CU-Rocketry/kicad-library/3d_models/RF_Antenna_Johanson_2450AT42E010BE.STEP

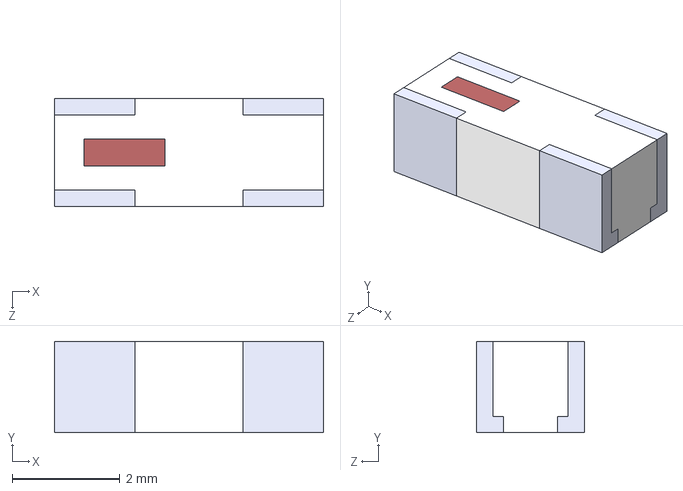
[picture p1: CAD file, 2026-07-11]
3d_models/RF_Antenna_Johanson_2450AT42E010BE.STEP
5.00 x 1.70 x 2.00 mm
