CU-Rocketry/kicad-library/3d_models/Wio-S3 Wireless Module_3D.step

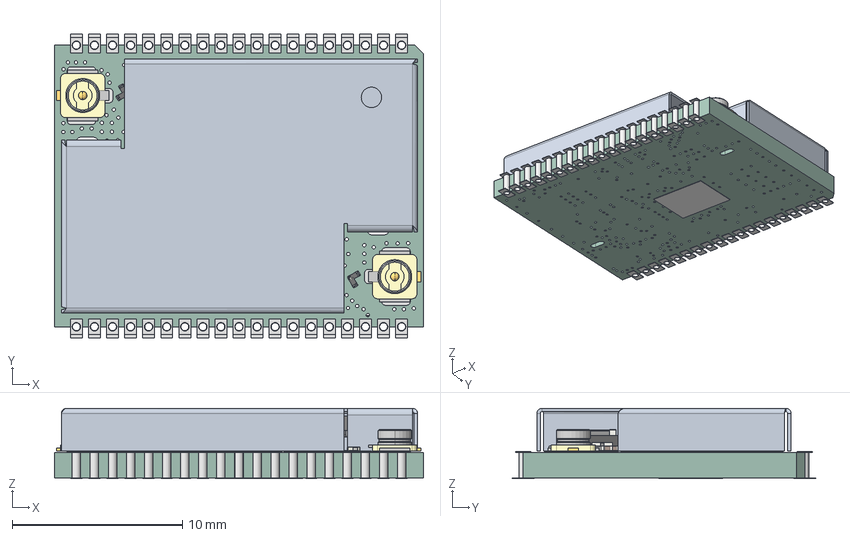
[picture p2: CAD file, 2026-07-07]
3d_models/Wio-S3 Wireless Module_3D.step
21.6 x 17.8 x 4.13 mm
C_0201_0603Metric x 35
L_0201_0603Metric x 7
R_0201_0603Metric x 10
C_0402_1005Metric x 7
Wio-S3 Wireless Module_3D 1.18.1
L_0402_1005Metric x 6
U.FL-R-SMT-1 x 2
Wio-S3 Wireless Module_3D 1.42.1
Wio-S3 Wireless Module å±è½ç½©
L_0805_2012Metric
Crystal_SMD_SeikoEpson_FA238-4Pin_2.5x2.0mm
QFN56-7x7
SOIC-8_5.275x5.275mm_P1.27mm
QFN24 4x4
SOD-523
Wio-S3 Wireless Module_pad
Wio-S3 Wireless Module_PCB
