CU-Rocketry/kicad-library/3d_models/CP_Radial_D13.5mm_P5.00mm_H8.00mm.step

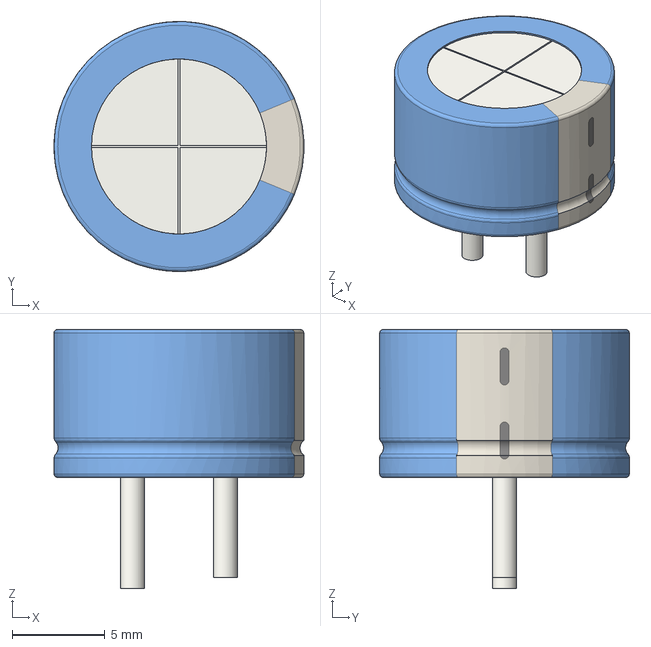
[picture p3: CAD file, 2026-07-04]
3d_models/CP_Radial_D13.5mm_P5.00mm_H8.00mm.step
13.5 x 13.5 x 14.0 mm
