CU-Rocketry/kicad-library/3d_models/GCT_USB4940-00-A.step

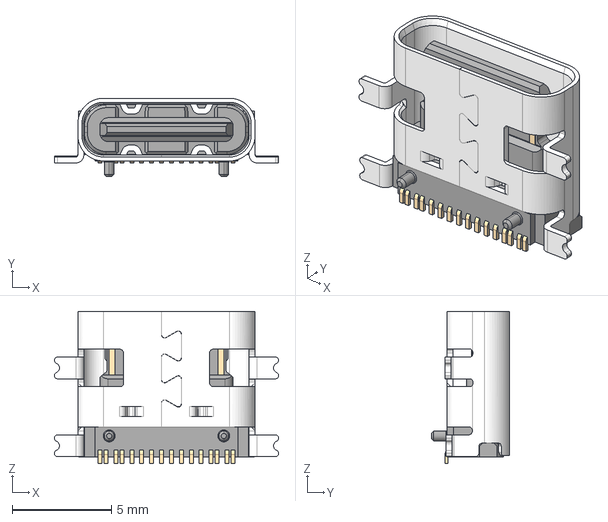
[picture p4: CAD file, 2026-07-04]
3d_models/GCT_USB4940-00-A.step
11.3 x 3.96 x 7.68 mm
