CU-Rocketry/kicad-library/3d_models/BA1AAPC.step

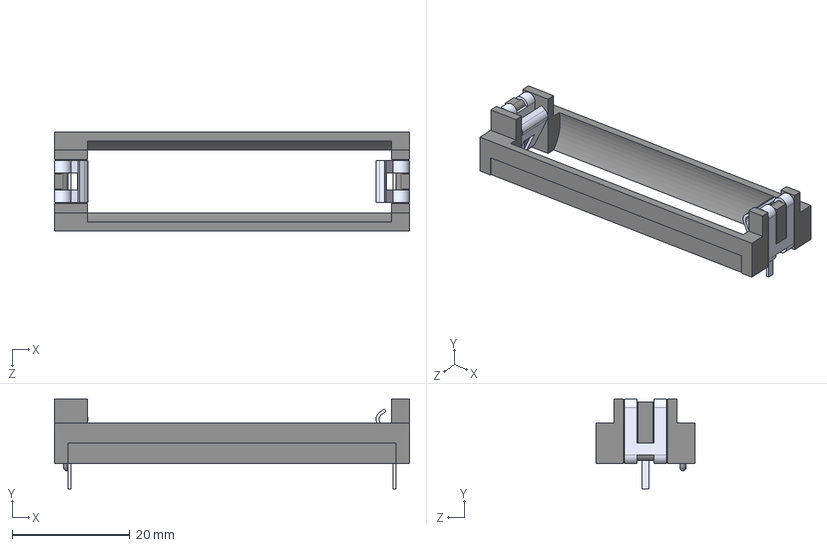
[picture p5: CAD file, 2026-06-29]
3d_models/BA1AAPC.step
60.2 x 15.2 x 16.8 mm
