CU-Rocketry/kicad-library/3d_models/FTSH-107-01-L-DV-K.step

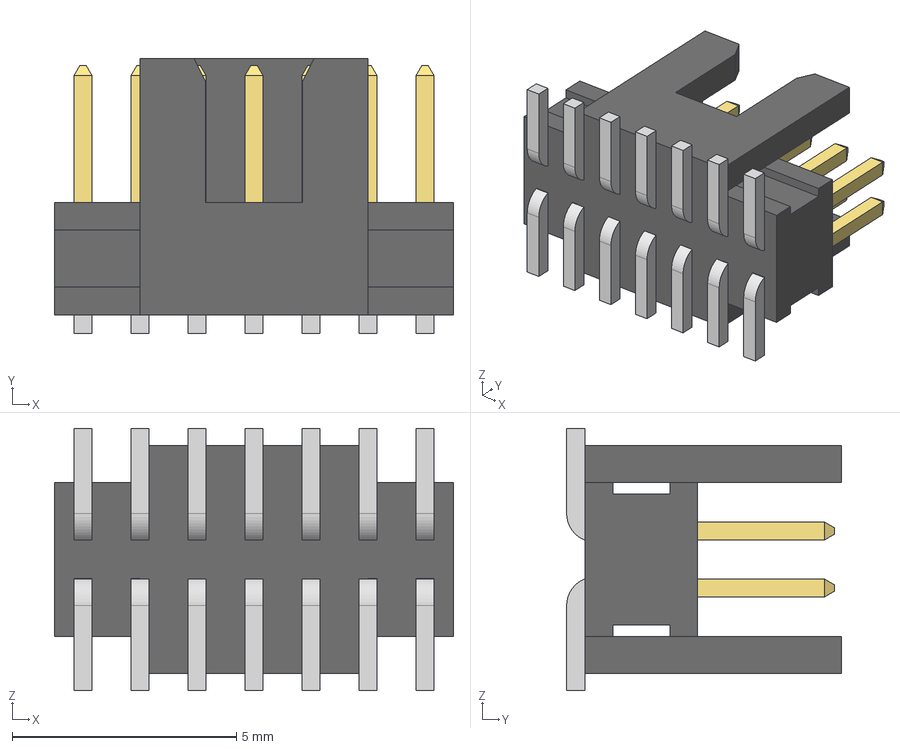
[picture p6: CAD file, 2026-06-27]
3d_models/FTSH-107-01-L-DV-K.step
8.89 x 6.12 x 5.84 mm
FTSH-107-01-L-DV-K_body
FTSH-107-01-L-DV-K_pins1
FTSH-107-01-L-DV-K_pins2
