CU-Rocketry/kicad-library/3d_models/UJ20-C-H-G-SMT-2A-P16-TR.step

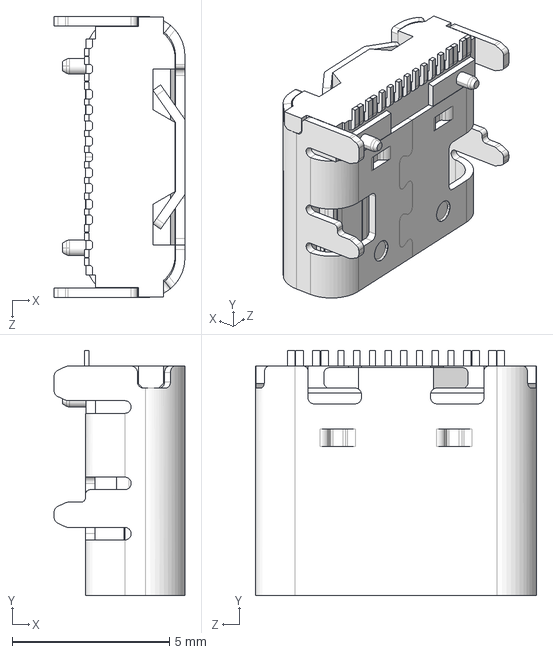
[picture p7: CAD file, 2026-06-27]
3d_models/UJ20-C-H-G-SMT-2A-P16-TR.step
4.16 x 7.80 x 8.94 mm
