CU-Rocketry/kicad-library/3d_models/ublox-SAM-M10Q-00B.step

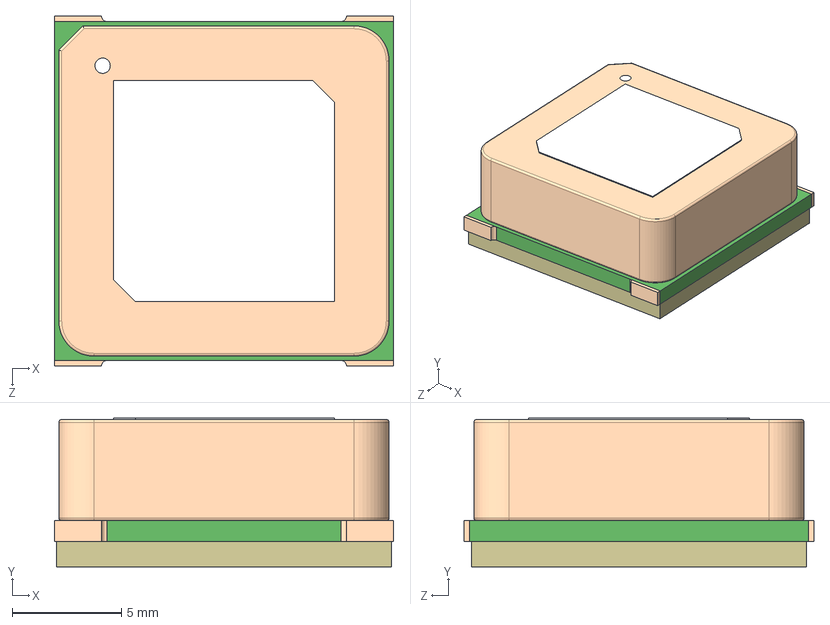
[picture p8: CAD file, 2026-06-19]
3d_models/ublox-SAM-M10Q-00B.step
15.5 x 6.80 x 16.0 mm
