CU-Rocketry/kicad-library/3d_models/E22-400MM22S.step

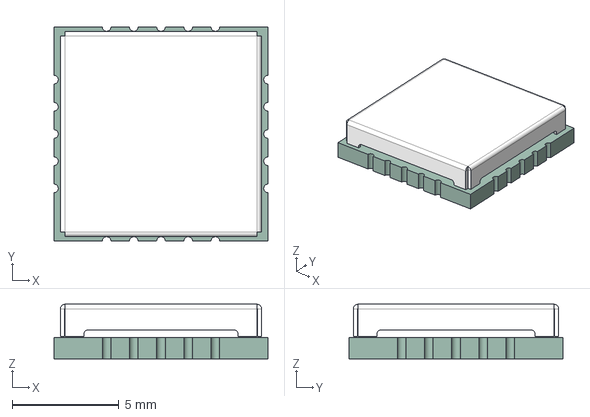
[picture p9: CAD file, 2026-04-06]
3d_models/E22-400MM22S.step
10.0 x 10.0 x 2.55 mm
PBZ-135
10705-V1.1_PCB
