CU-Rocketry/kicad-library/3d_models/XT30U-M.step

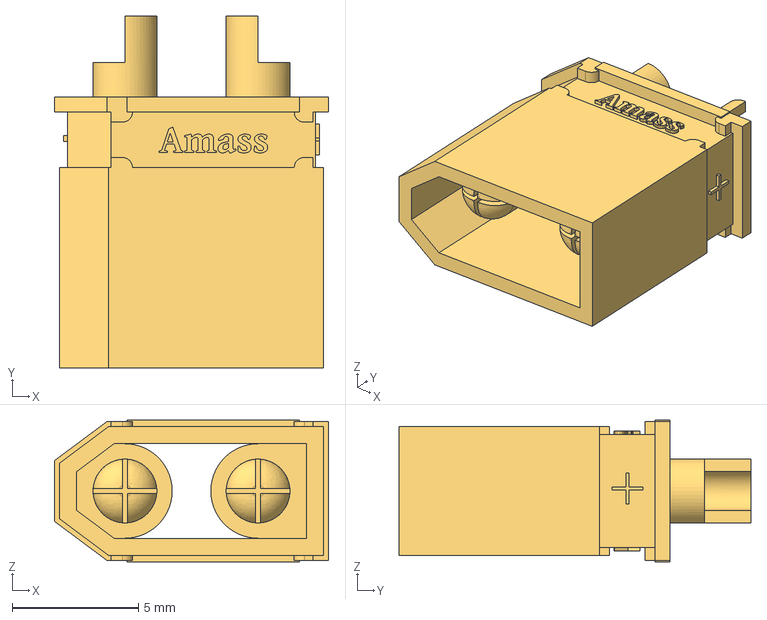
[picture p10: CAD file, 2026-04-06]
3d_models/XT30U-M.step
10.9 x 14.0 x 5.62 mm
