CU-Rocketry/kicad-library/3d_models/Same_Sky_TB0011-350-02GR.step

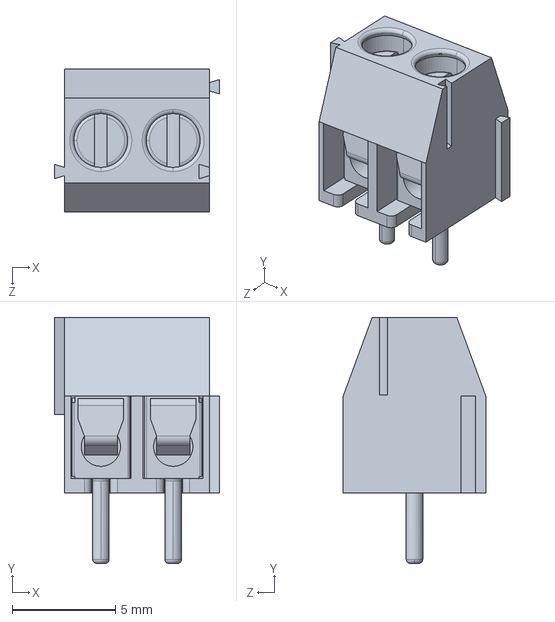
[picture p11: CAD file, 2026-04-06]
3d_models/Same_Sky_TB0011-350-02GR.step
8.00 x 11.9 x 6.90 mm
