CU-Rocketry/kicad-library/3d_models/ublox-SAM-M8Q-0.STEP

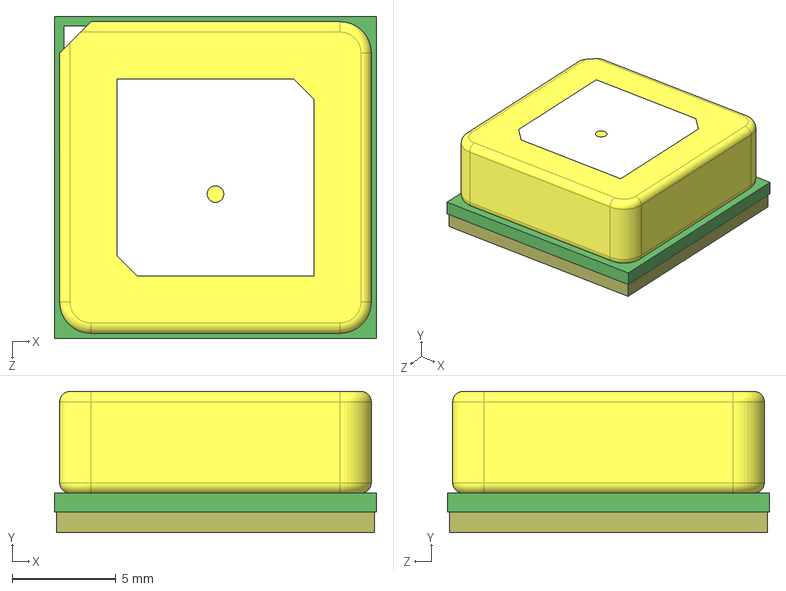
[picture p12: CAD file, 2026-04-06]
3d_models/ublox-SAM-M8Q-0.STEP
15.5 x 6.80 x 15.5 mm
