CU-Rocketry/kicad-library/3d_models/LED_Cree-PLCC4_3.2x2.8mm.step

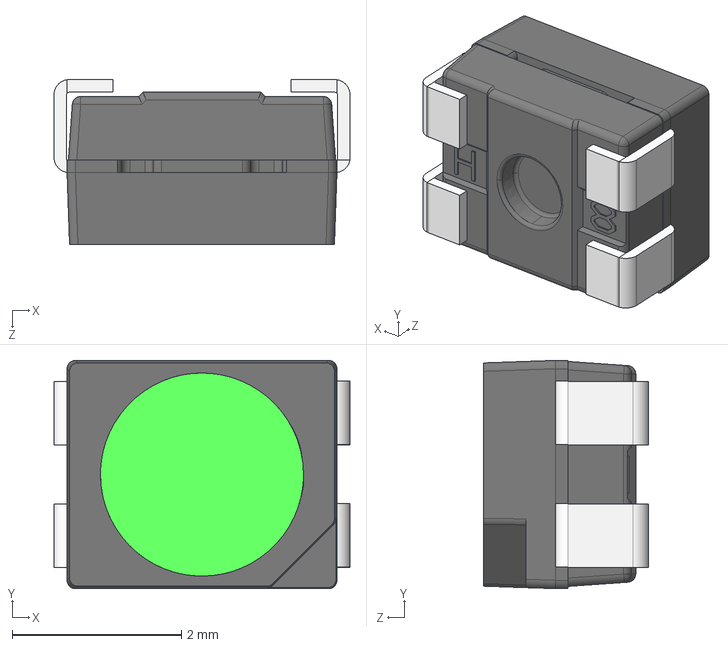
[picture p13: CAD file, 2026-04-06]
3d_models/LED_Cree-PLCC4_3.2x2.8mm.step
3.50 x 2.70 x 1.95 mm
