CU-Rocketry/kicad-library/3d_models/TB0011-350-03GR.step

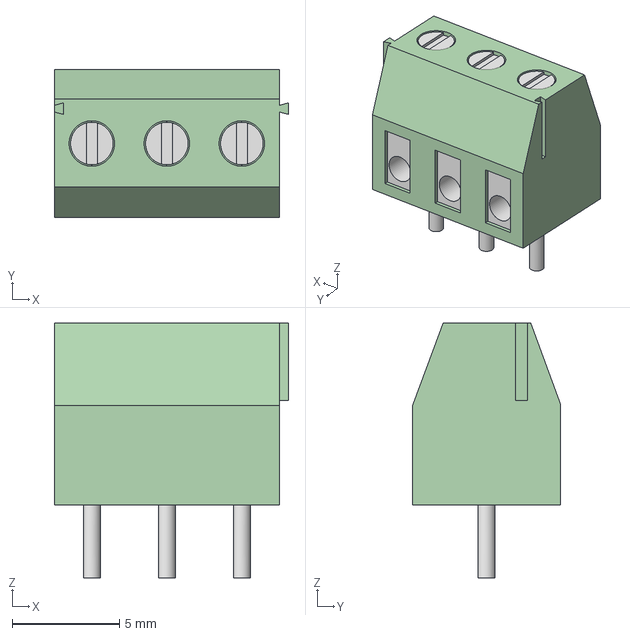
[picture p14: CAD file, 2026-04-06]
3d_models/TB0011-350-03GR.step
10.9 x 6.90 x 11.9 mm
