CU-Rocketry/kicad-library/3d_models/XDFN8_1P6X1P2_onsemi.step

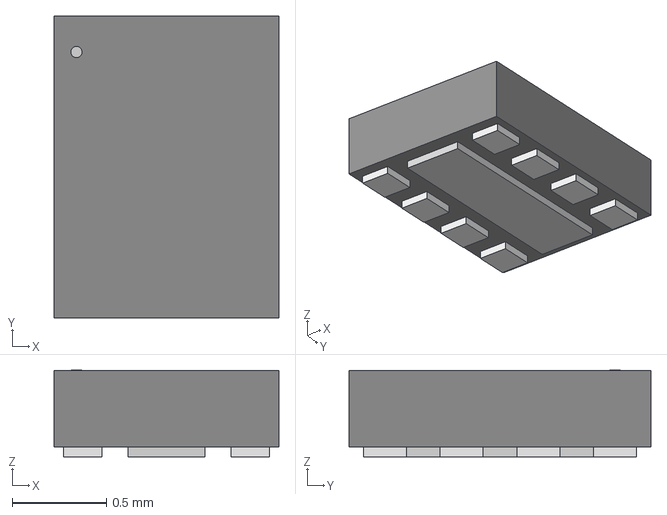
[picture p15: CAD file, 2026-02-26]
3d_models/XDFN8_1P6X1P2_onsemi.step
1.19 x 1.60 x 0.46 mm
