CU-Rocketry/kicad-library/3d_models/TVS_ESDA7P120-1U1M.step

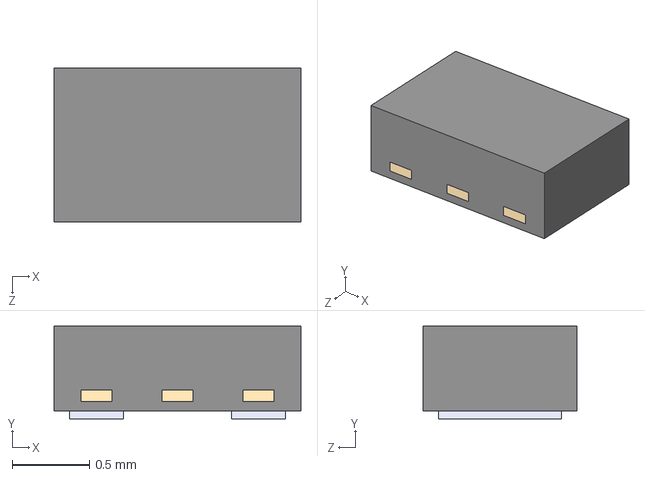
[picture p16: CAD file, 2026-02-18]
3d_models/TVS_ESDA7P120-1U1M.step
1.60 x 0.6 x 1.00 mm
