CU-Rocketry/kicad-library/3d_models/Buzzer_CMT-7525-03-SMT-TR.step

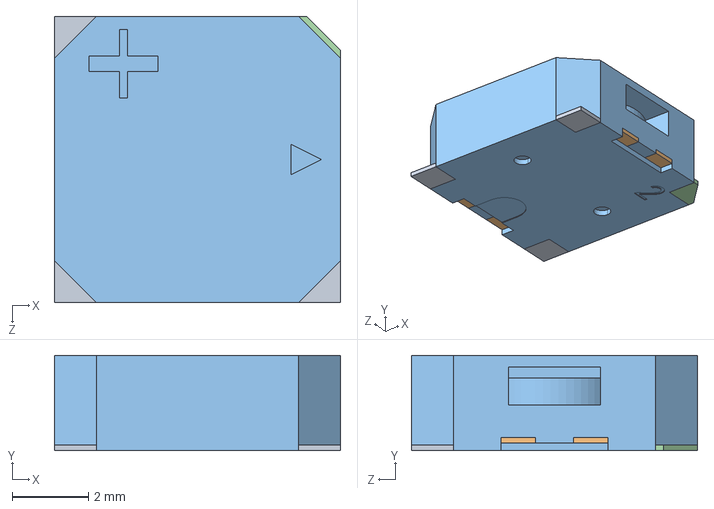
[picture p17: CAD file, 2026-02-12]
3d_models/Buzzer_CMT-7525-03-SMT-TR.step
7.50 x 2.50 x 7.50 mm
