CU-Rocketry/kicad-library/3d_models/NTR4003NT1G.stp

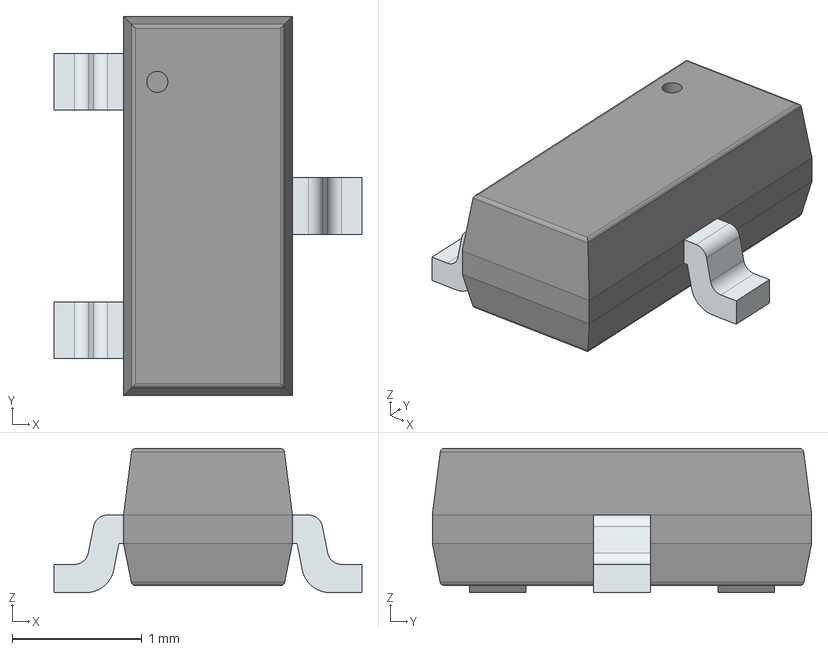
[picture p18: CAD file, 2026-01-28]
3d_models/NTR4003NT1G.stp
2.37 x 2.92 x 1.11 mm
PinsArrayL
FilletPinR
