CU-Rocketry/kicad-library/3d_models/Samtec_FTSH-107-01-X-DV-K-TR.step

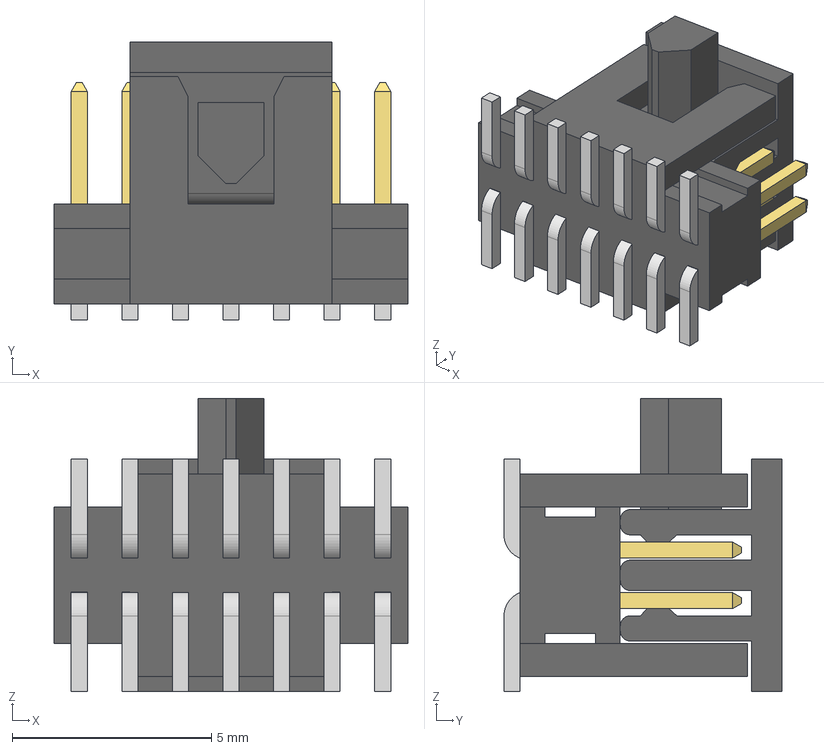
[picture p19: CAD file, 2026-01-27]
3d_models/Samtec_FTSH-107-01-X-DV-K-TR.step
8.89 x 6.98 x 7.37 mm
FTSH-107-01-F-DV-K-P-TR_body
FTSH-107-01-F-DV-K-P-TR_pins1
FTSH-107-01-F-DV-K-P-TR_pins2
FTSH-107-01-F-DV-K-P-TR_pp_pad
