CU-Rocketry/kicad-library/3d_models/UP20-C-F-G-FL-1-P12-TR.step

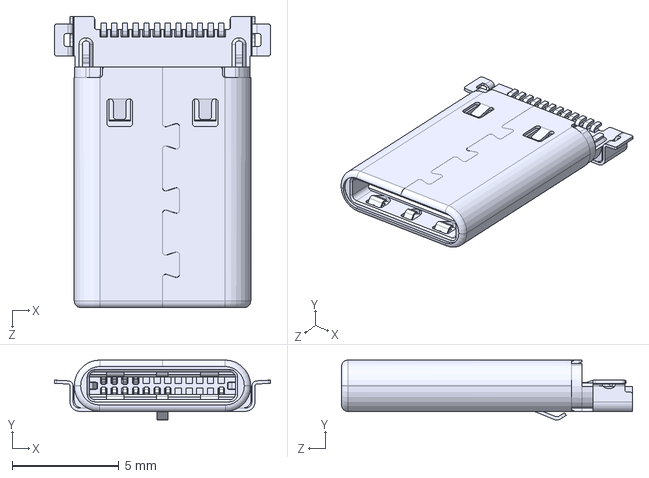
[picture p20: CAD file, 2026-01-27]
3d_models/UP20-C-F-G-FL-1-P12-TR.step
10.1 x 2.80 x 13.6 mm
