CU-Rocketry/kicad-library/3d_models/UJ20-C-H-G-SMT-5-P16-TR.step

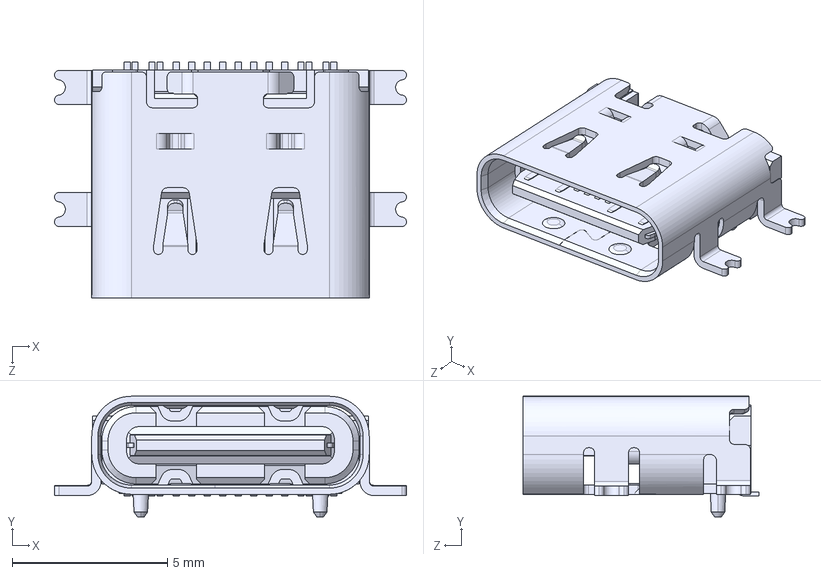
[picture p21: CAD file, 2026-01-27]
3d_models/UJ20-C-H-G-SMT-5-P16-TR.step
11.3 x 3.89 x 7.60 mm
