CU-Rocketry/kicad-library/3d_models/Con_Coaxial_RFSOLUTIONS_CON-SMA-EDGE-S.step

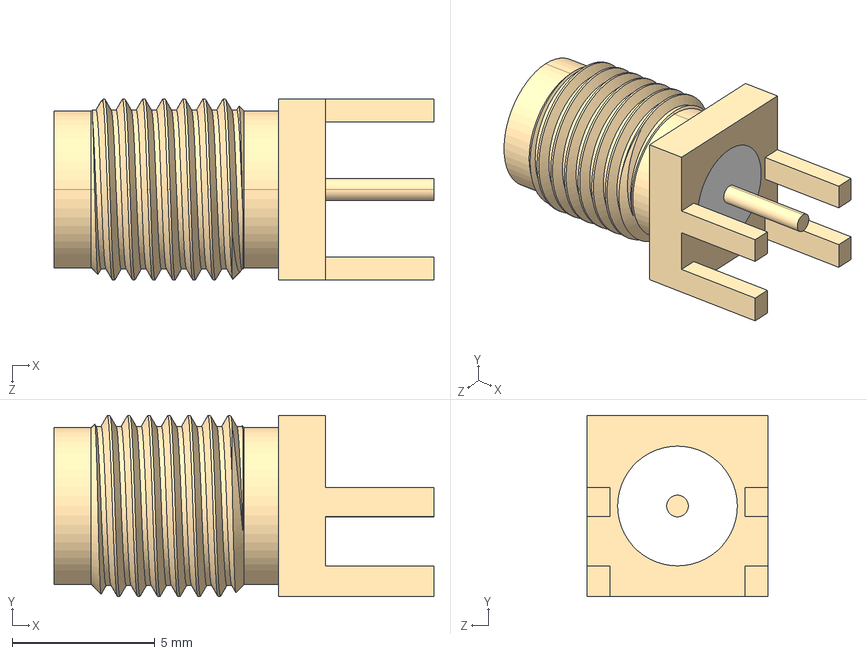
[picture p22: CAD file, 2026-01-21]
3d_models/Con_Coaxial_RFSOLUTIONS_CON-SMA-EDGE-S.step
13.3 x 6.35 x 6.35 mm
