CU-Rocketry/kicad-library/3d_models/SW_SameSky_SLW-121456-3A-N-D.step

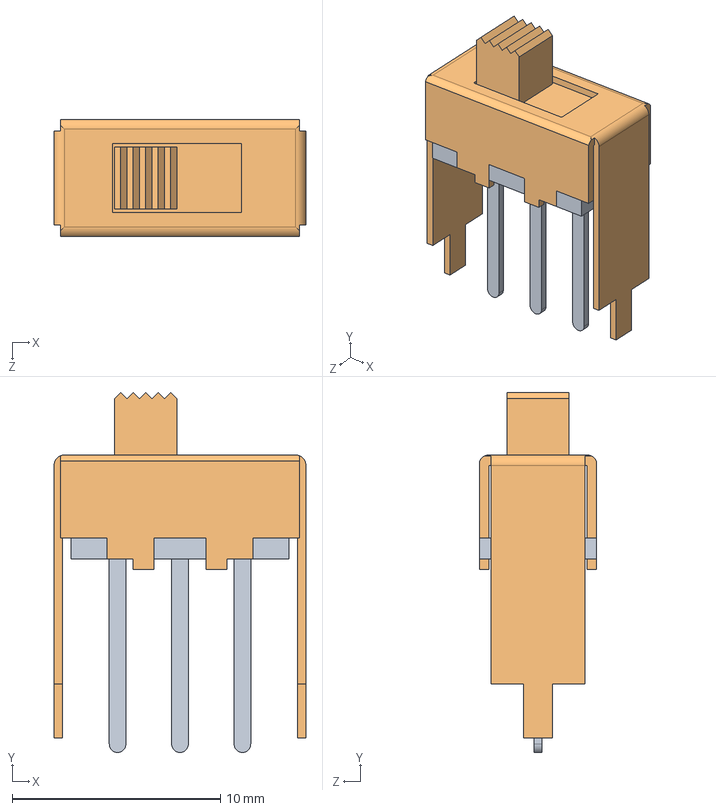
[picture p23: CAD file, 2026-01-21]
3d_models/SW_SameSky_SLW-121456-3A-N-D.step
12.1 x 17.3 x 5.60 mm
