CU-Rocketry/kicad-library/3d_models/SW_SameSky_SLW-12689-4A-N-D.step

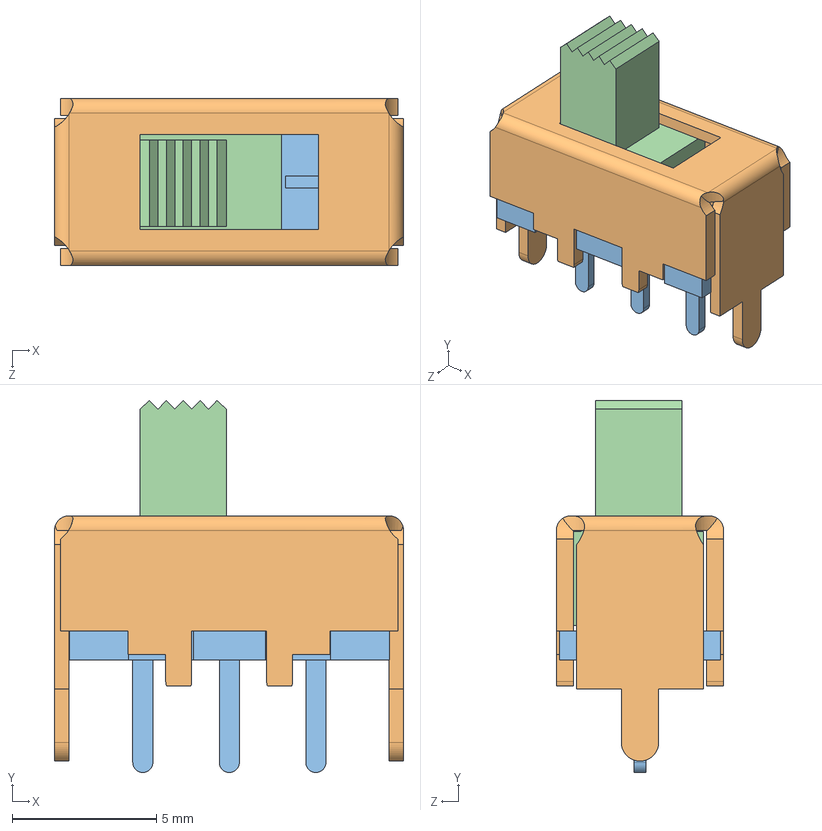
[picture p24: CAD file, 2026-01-20]
3d_models/SW_SameSky_SLW-12689-4A-N-D.step
12.1 x 12.9 x 5.80 mm
