CU-Rocketry/kicad-library/3d_models/19-237-R6GHBHC-M01-2T.step

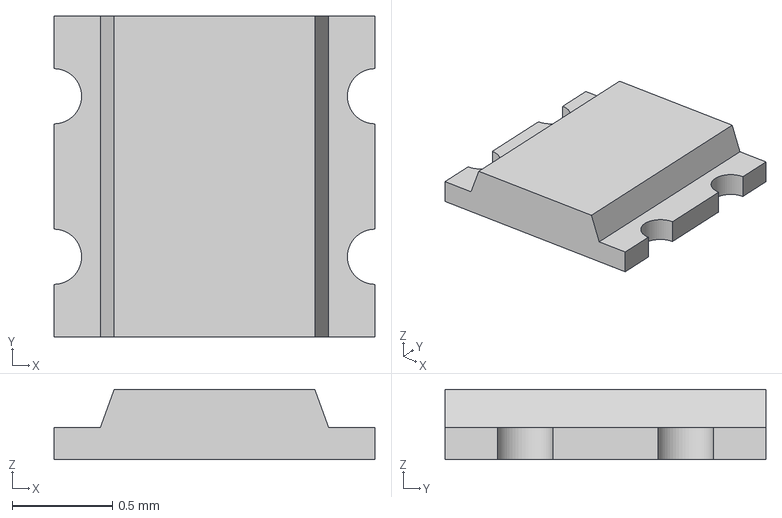
[picture p25: CAD file, 2026-01-20]
3d_models/19-237-R6GHBHC-M01-2T.step
1.60 x 1.60 x 0.35 mm
