CU-Rocketry/kicad-library/3d_models/Molex_436500415.stp

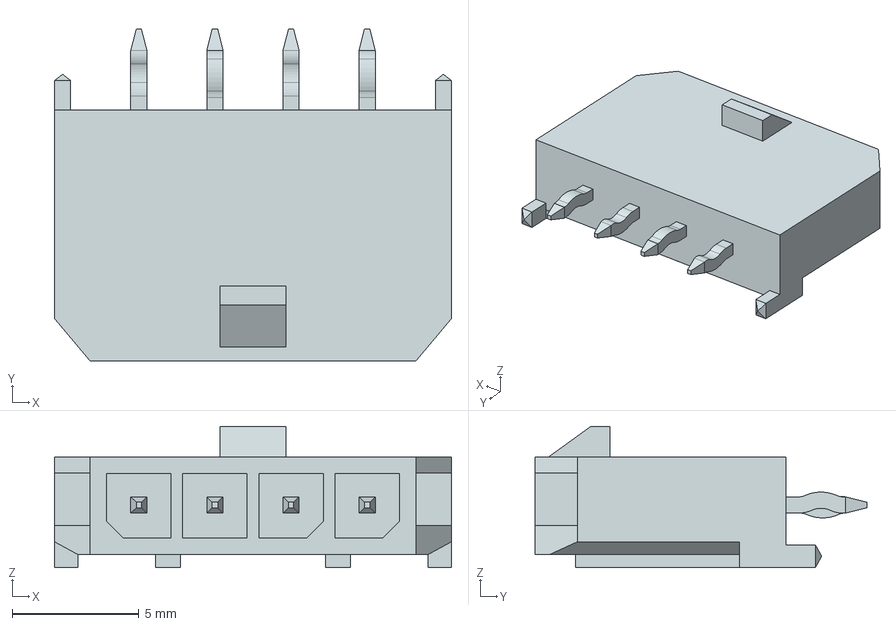
[picture p26: CAD file, 2026-01-20]
3d_models/Molex_436500415.stp
15.7 x 13.1 x 5.57 mm
