CU-Rocketry/kicad-library/3d_models/Buzzer_SameSky_CEM-1203_42.step

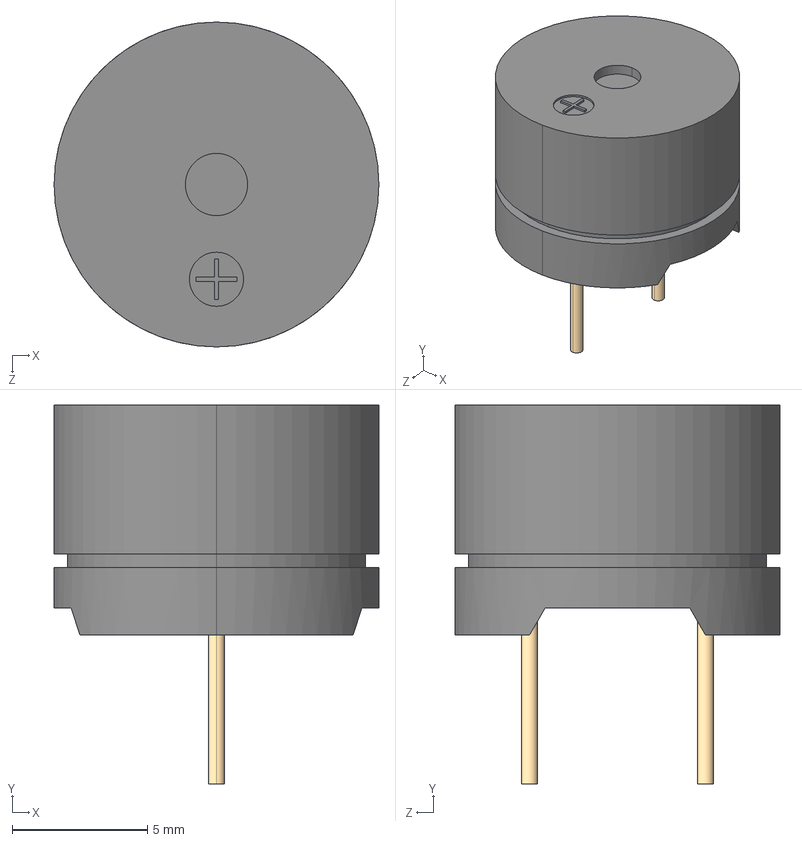
[picture p27: CAD file, 2026-01-20]
3d_models/Buzzer_SameSky_CEM-1203_42.step
12.0 x 14.0 x 12.0 mm
