CU-Rocketry/kicad-library/3d_models/SW_SameSky_RDS4-8S-1012-73-RA-254-D-67.step

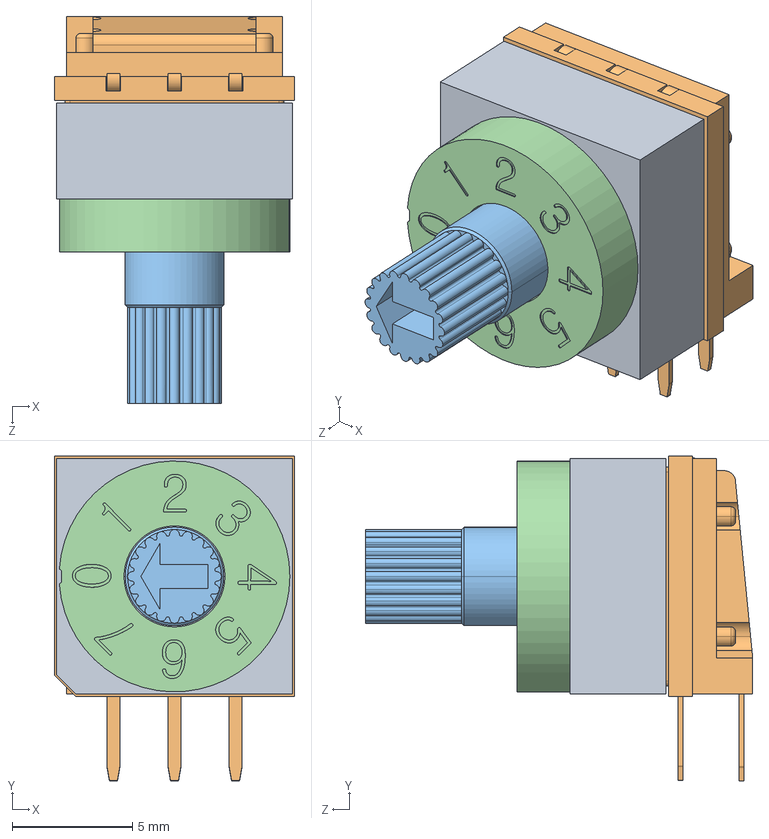
[picture p28: CAD file, 2026-01-20]
3d_models/SW_SameSky_RDS4-8S-1012-73-RA-254-D-67.step
10.0 x 13.5 x 16.1 mm
RDS4-1012-73-RA HOUSING
RDS4-1012-73-RA-254 HOUSING
RDS4-73-8 POSITION
