CU-Rocketry/kicad-library/3d_models/TestPoint_KOASpeer_RCUCTE.step

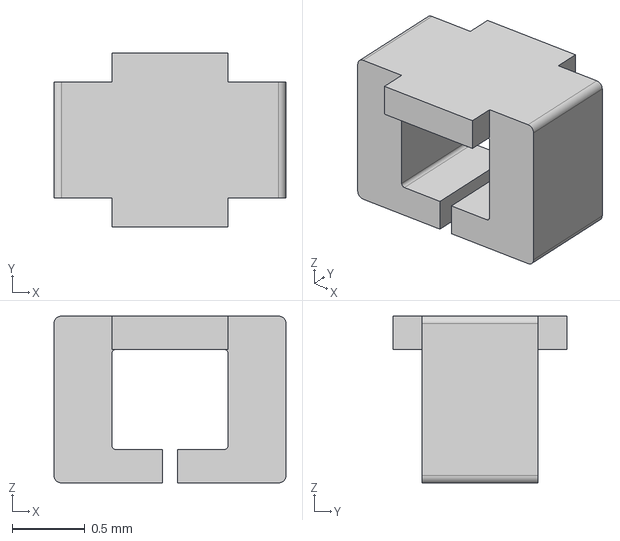
[picture p29: CAD file, 2026-01-20]
3d_models/TestPoint_KOASpeer_RCUCTE.step
1.60 x 1.20 x 1.15 mm
