CU-Rocketry/kicad-library/3d_models/EBYTE_LoRa_E22-400M30S.step

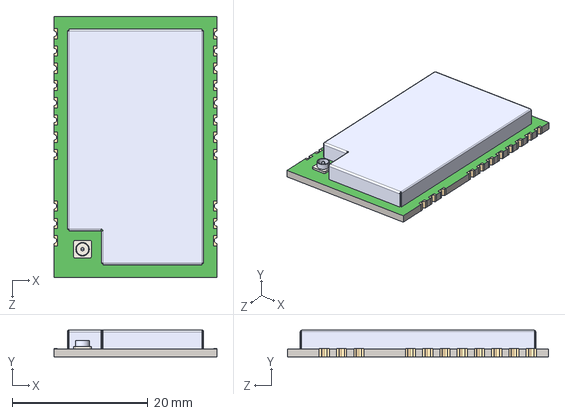
[picture p30: CAD file, 2026-01-20]
3d_models/EBYTE_LoRa_E22-400M30S.step
24.0 x 3.97 x 38.5 mm
