CU-Rocketry/kicad-library/3d_models/L_Arlitech_AMPI0640ED2R2MT v1.step

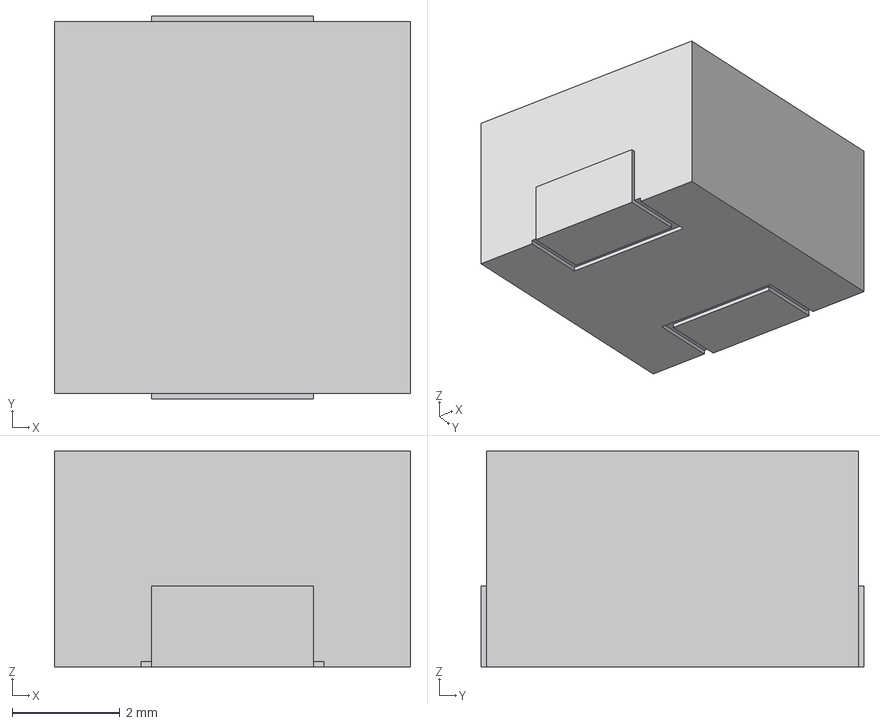
[picture p31: CAD file, 2026-01-20]
3d_models/L_Arlitech_AMPI0640ED2R2MT v1.step
6.60 x 7.10 x 4.00 mm
