CU-Rocketry/kicad-library/3d_models/Buzzer_SameSky_CPT-1207-3TH.step

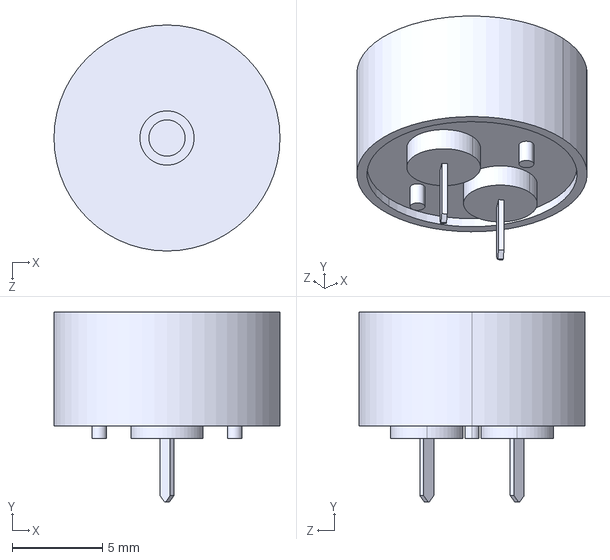
[picture p32: CAD file, 2026-01-20]
3d_models/Buzzer_SameSky_CPT-1207-3TH.step
12.5 x 10.5 x 12.5 mm
