CU-Rocketry/kicad-library/3d_models/LED_Harvatek_B38G3RGB-10D0003H2U1930.step

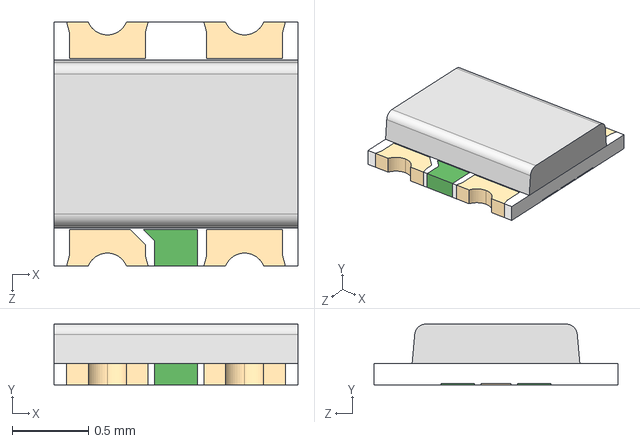
[picture p33: CAD file, 2026-01-20]
3d_models/LED_Harvatek_B38G3RGB-10D0003H2U1930.step
1.60 x 0.4 x 1.60 mm
