CU-Rocketry/kicad-library/3d_models/ST_IIS2MDCTR.STEP

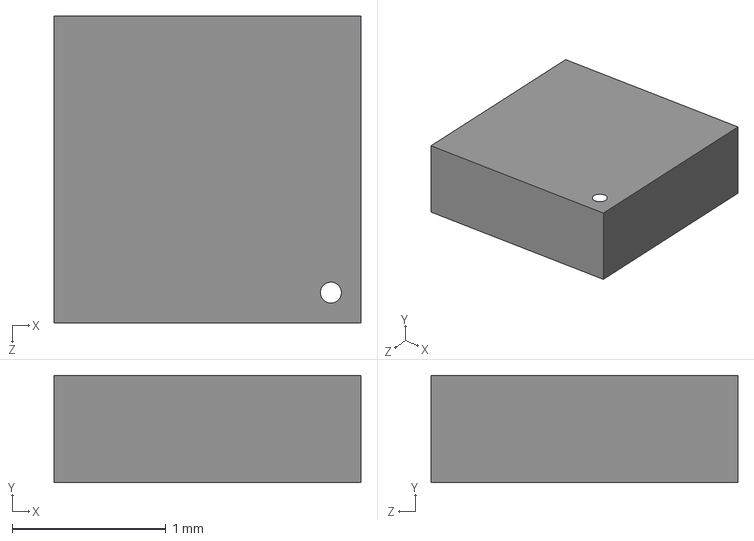
[picture p34: CAD file, 2026-01-20]
3d_models/ST_IIS2MDCTR.STEP
2.00 x 0.7 x 2.00 mm
