CU-Rocketry/kicad-library/3d_models/XT30PW-M.STEP

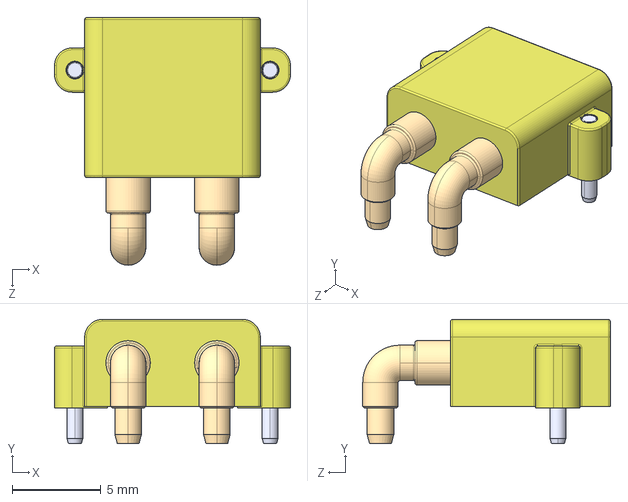
[picture p36: CAD file, 2025-08-24]
3d_models/XT30PW-M.STEP
13.3 x 7.00 x 14.0 mm
