CU-Rocketry/kicad-library/3d_models/STM32C011F4U6TR.STEP

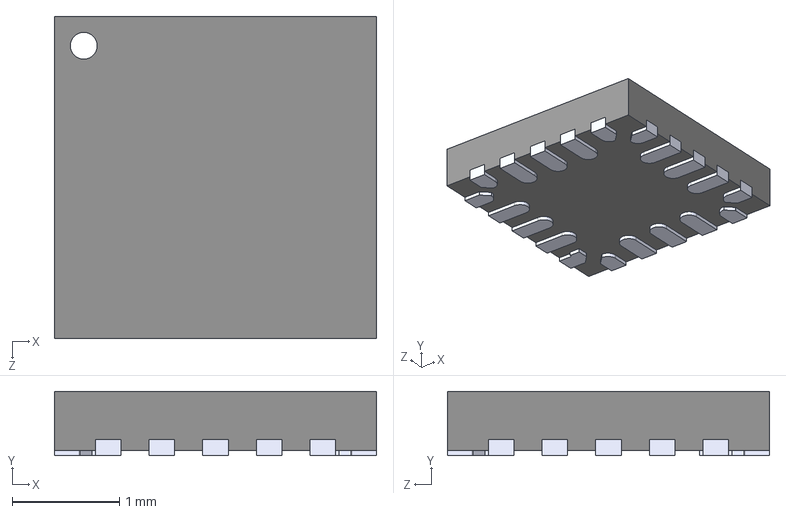
[picture p37: CAD file, 2025-08-24]
3d_models/STM32C011F4U6TR.STEP
3.00 x 0.6 x 3.00 mm
