CU-Rocketry/kicad-library/3d_models/XT30PW-F.STEP

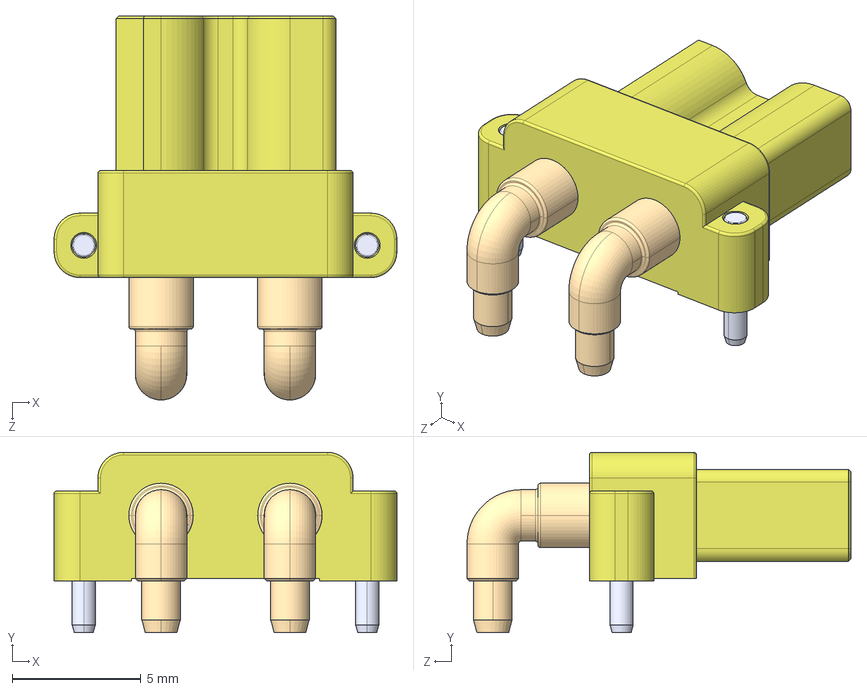
[picture p38: CAD file, 2025-08-24]
3d_models/XT30PW-F.STEP
13.3 x 7.00 x 14.9 mm
