CU-Rocketry/kicad-library/3d_models/TESEO-LIV3R.stp

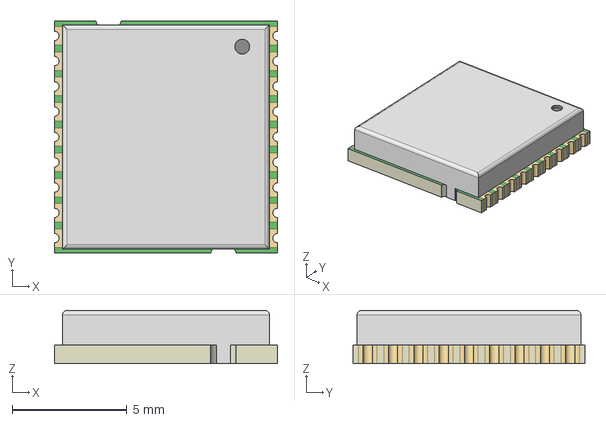
[picture p39: CAD file, 2025-08-23]
3d_models/TESEO-LIV3R.stp
9.70 x 10.1 x 2.31 mm
