CU-Rocketry/kicad-library/3d_models/RF_Module_Seeed_LoRa-E5.step

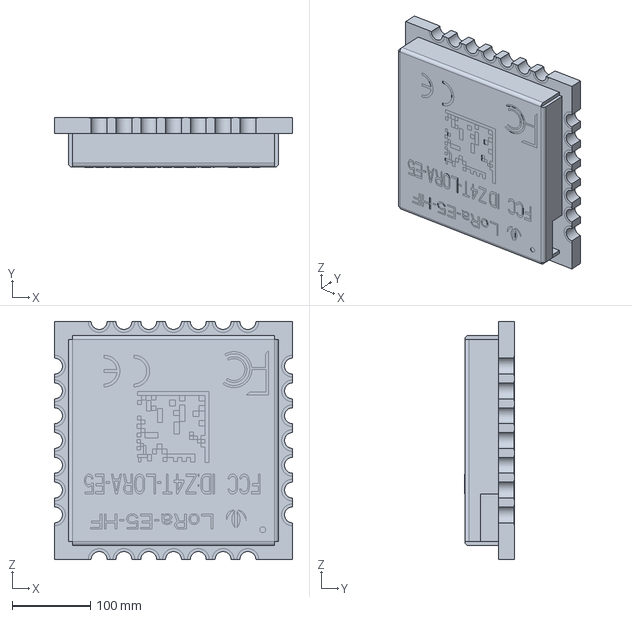
[picture p40: CAD file, 2025-08-23]
3d_models/RF_Module_Seeed_LoRa-E5.step
304.8 x 63.8 x 304.8 mm
