CU-Rocketry/kicad-library/3d_models/3220-10-0100-00.STEP

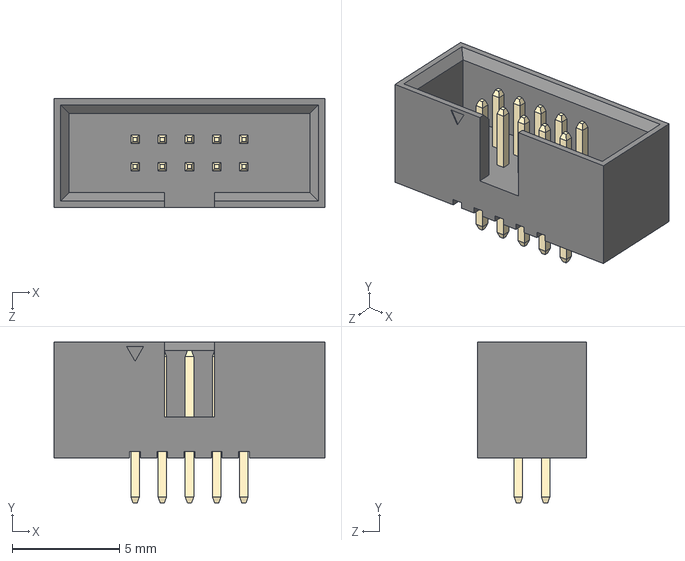
[picture p41: CAD file, 2025-08-23]
3d_models/3220-10-0100-00.STEP
12.7 x 7.50 x 5.10 mm
3220-xx-0100-00 body_10
Pin^3220-xx-0100-00 x 10
