CU-Rocketry/kicad-library/3d_models/UJ20-C-H-G-SMT-P16-TR.step

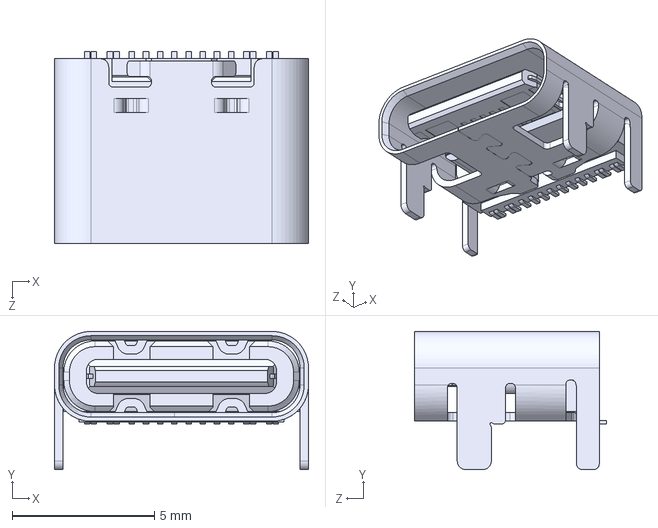
[picture p42: CAD file, 2025-08-23]
3d_models/UJ20-C-H-G-SMT-P16-TR.step
8.94 x 4.86 x 6.75 mm
