CU-Rocketry/kicad-library/3d_models/BM04B-SRSS-TB.STEP

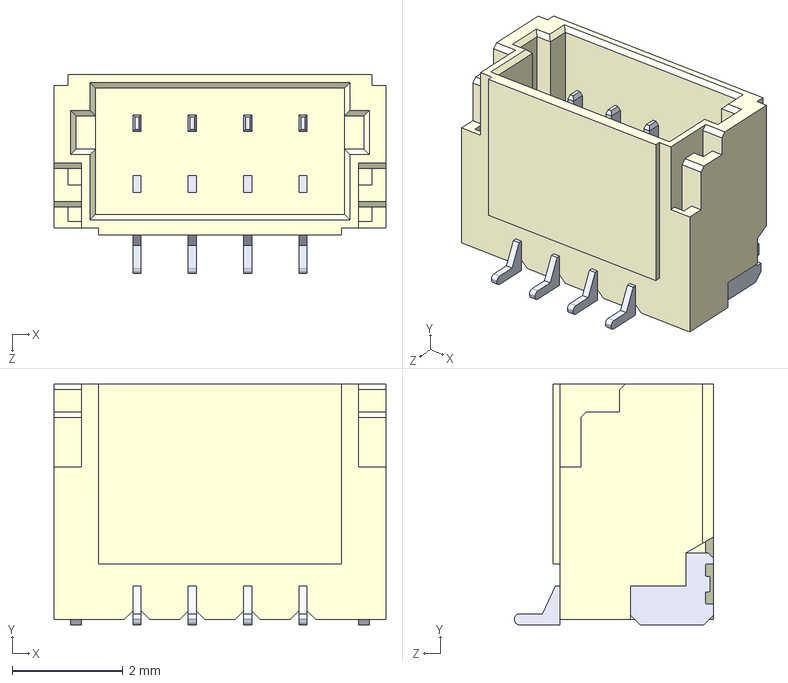
[picture p43: CAD file, 2025-08-23]
3d_models/BM04B-SRSS-TB.STEP
6.00 x 4.35 x 3.60 mm
