CU-Rocketry/kicad-library/3d_models/SW_SameSky_SLW-864574-5A-RA-N-D.step

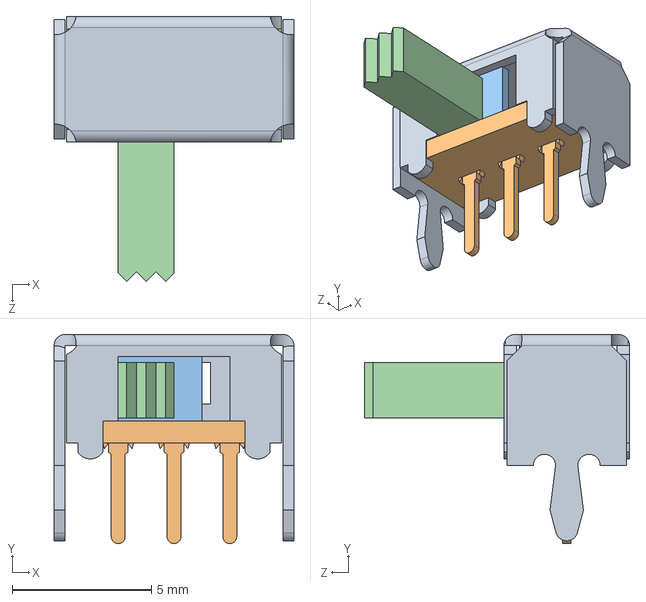
[picture p44: CAD file, 2025-08-23]
3d_models/SW_SameSky_SLW-864574-5A-RA-N-D.step
8.60 x 7.50 x 9.50 mm
