CU-Rocketry/kicad-library/3d_models/Keystone_BAT_2997.step

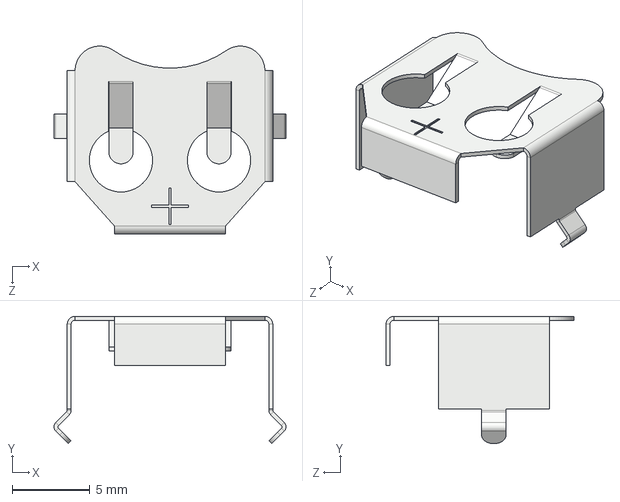
[picture p45: CAD file, 2025-08-23]
3d_models/Keystone_BAT_2997.step
14.9 x 8.18 x 12.1 mm
