CU-Rocketry/kicad-library/3d_models/SM04B-SRSS-TB.STEP

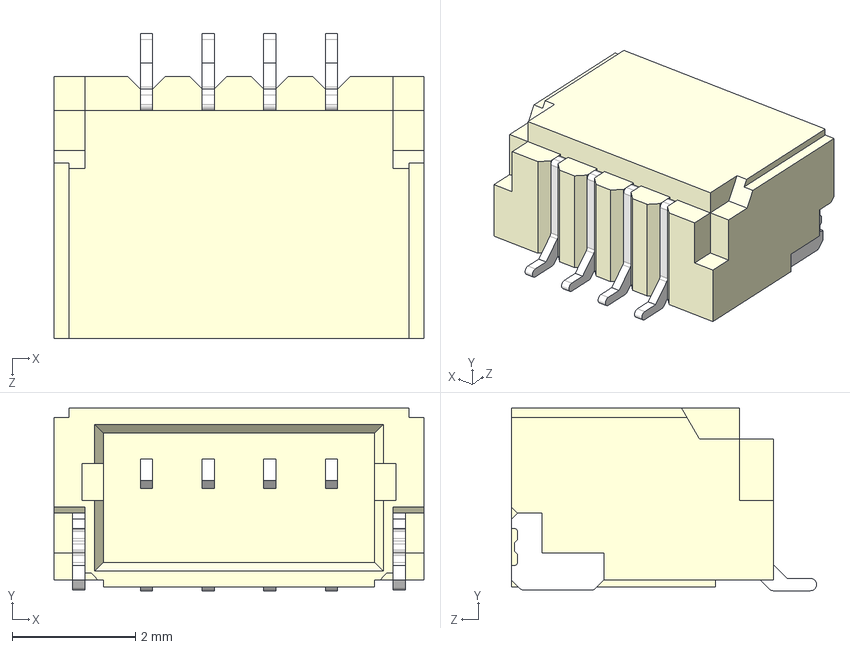
[picture p46: CAD file, 2025-08-23]
3d_models/SM04B-SRSS-TB.STEP
6.00 x 2.96 x 4.95 mm
