CU-Rocketry/kicad-library/3d_models/XT60PW-M.STEP

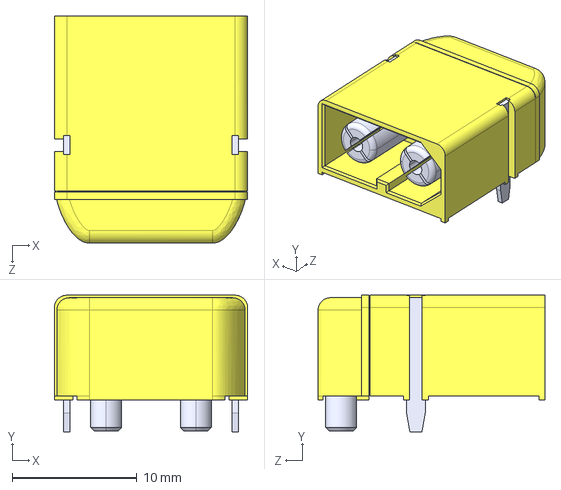
[picture p47: CAD file, 2025-08-23]
3d_models/XT60PW-M.STEP
15.5 x 11.0 x 18.2 mm
