CU-Rocketry/kicad-library/3d_models/BUK9K25-40RAX.stp

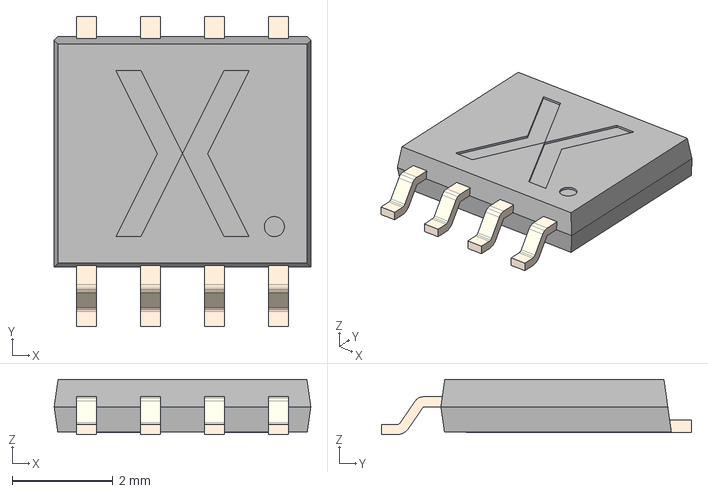
[picture p48: CAD file, 2025-08-23]
3d_models/BUK9K25-40RAX.stp
5.10 x 6.16 x 1.10 mm
