CU-Rocketry/kicad-library/3d_models/APAE1575R1820ABDC1-T.STEP

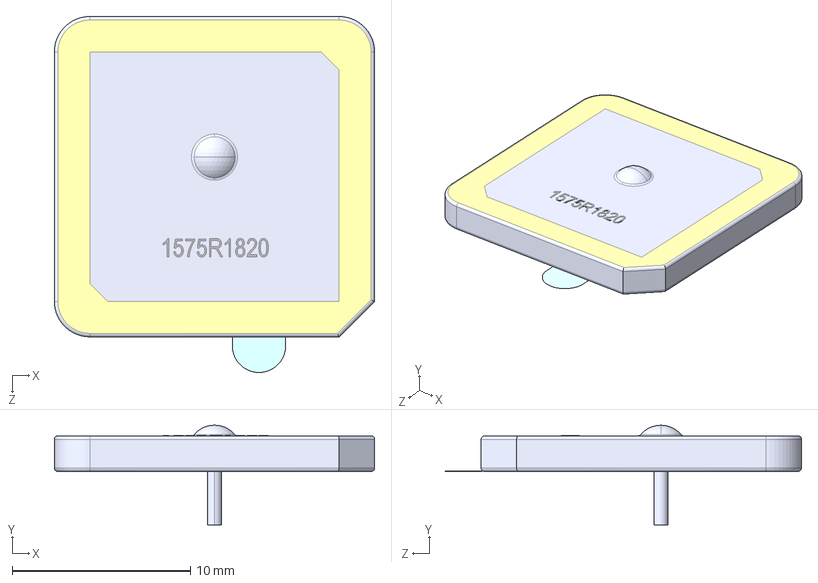
[picture p49: CAD file, 2025-08-23]
3d_models/APAE1575R1820ABDC1-T.STEP
18.0 x 5.60 x 20.0 mm
