CU-Rocketry/kicad-library/3d_models/MSD-4-A.STEP

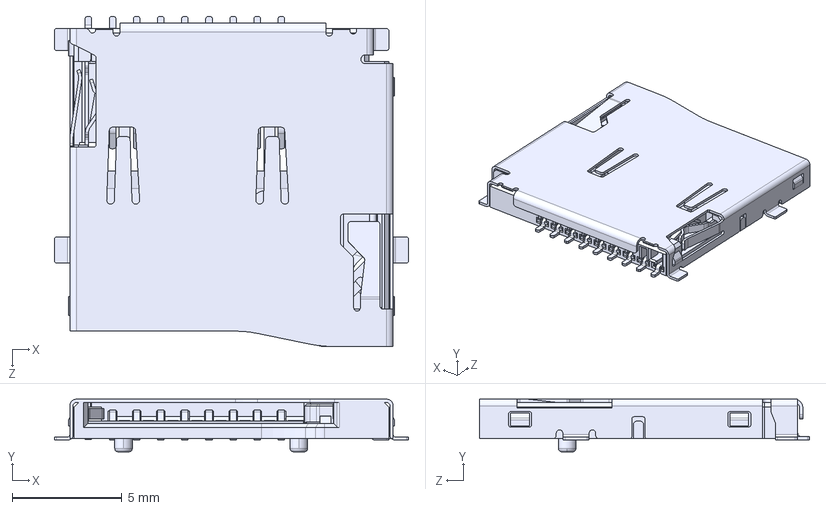
[picture p50: CAD file, 2025-08-23]
3d_models/MSD-4-A.STEP
16.1 x 2.40 x 15.0 mm
