CU-Rocketry/kicad-library/3d_models/SSOP5_ROM.step

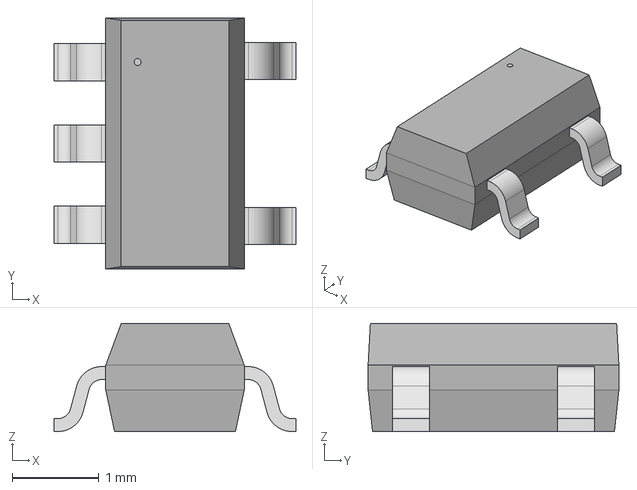
[picture p51: CAD file, 2025-04-07]
3d_models/SSOP5_ROM.step
2.79 x 2.90 x 1.25 mm
