CU-Rocketry/kicad-library/3d_models/CT09E-04T273-5.stp

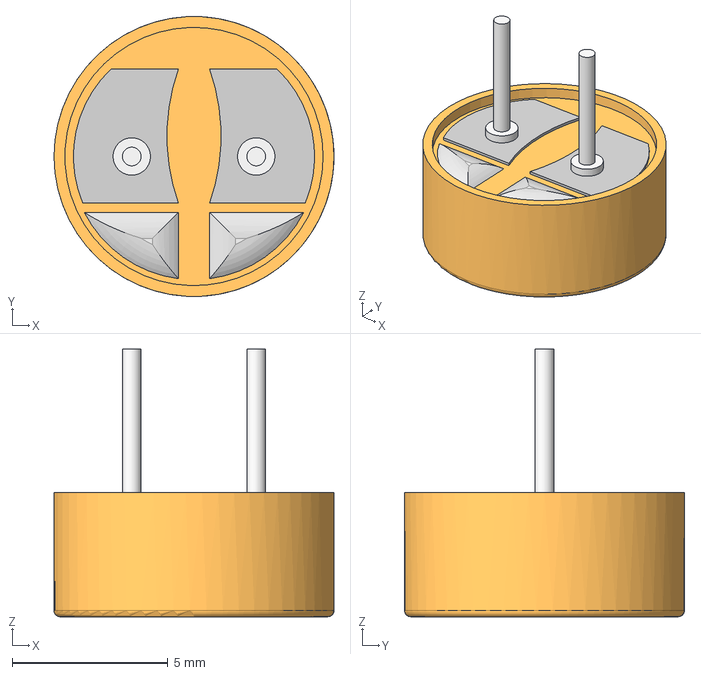
[picture p53: CAD file, 2025-03-31]
3d_models/CT09E-04T273-5.stp
9.00 x 9.00 x 8.60 mm
09Q
09Qxc1
