CU-Rocketry/kicad-library/3d_models/WeAct-EpaperModule-2.13.step

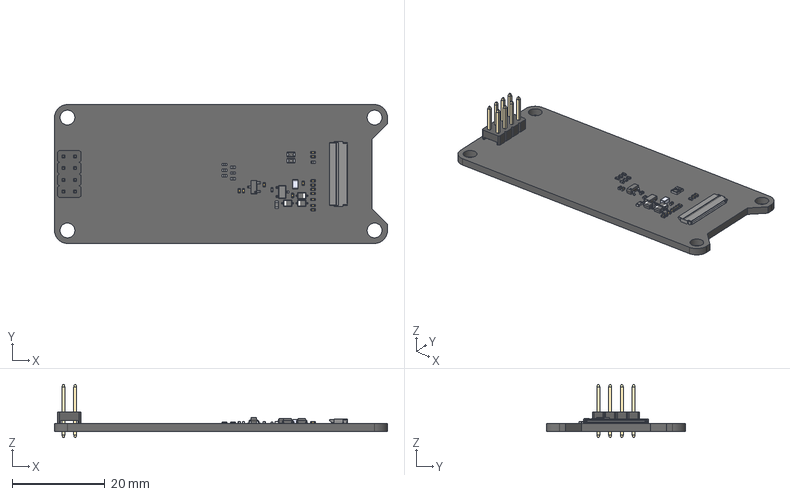
[picture p54: CAD file, 2025-03-16]
3d_models/WeAct-EpaperModule-2.13.step
72.0 x 30.0 x 11.5 mm
User Library-SOT23-3
R0603 x 2
Extruded x 2
Mid_Body x 9
Mark x 9
Leader x 3
pin_header_awl254-dg-g08d
User Library-Chip Inductor (2)
FH34SRJ-24S-0.5SH_RGB4408131
SOD323 x 3
