CU-Rocketry/kicad-library/3d_models/EVQ-P7A01P.stp

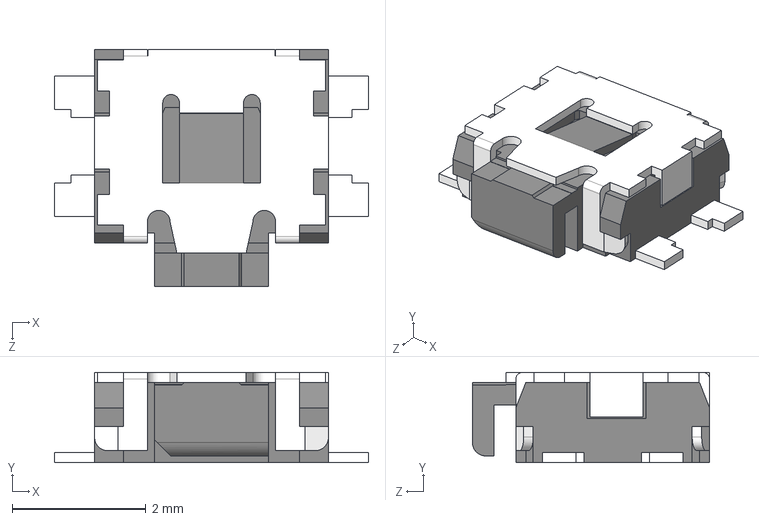
[picture p55: CAD file, 2025-03-01]
3d_models/EVQ-P7A01P.stp
4.70 x 1.35 x 3.55 mm
