CU-Rocketry/kicad-library/3d_models/PTS636SL50LFS.stp

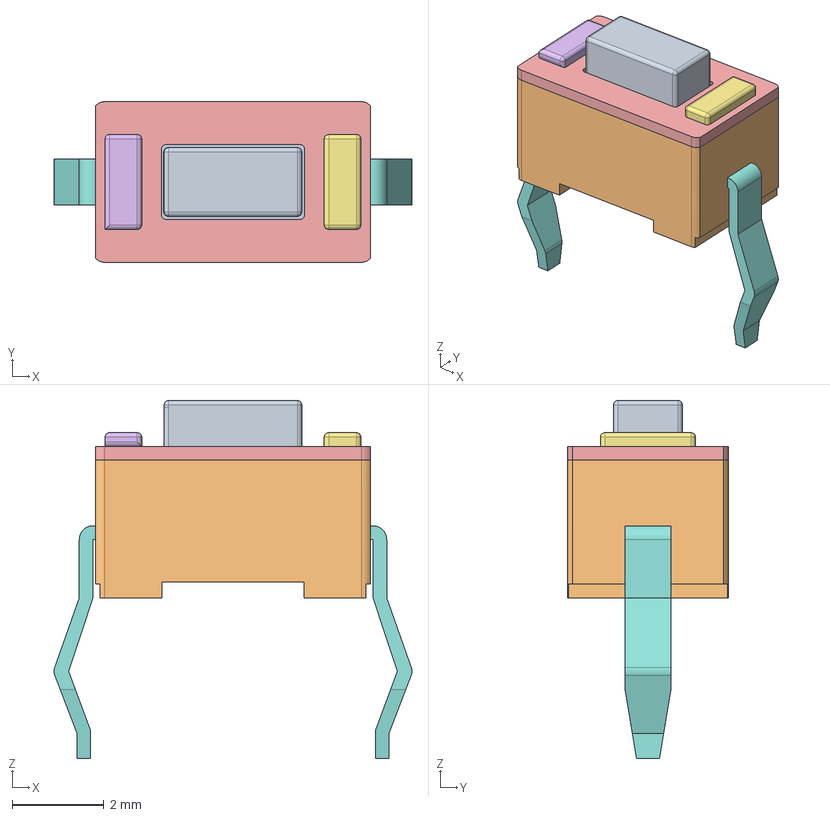
[picture p56: CAD file, 2025-03-01]
3d_models/PTS636SL50LFS.stp
7.80 x 3.50 x 7.80 mm
PTS636SL50LFS_PART1
PTS636SL50LFS_PART2
PTS636SL50LFS_PART3
PTS636SL50LFS_PART4
PTS636SL50LFS_PART5
PTS636SL50LFS_PART6
PTS636SL50LFS_PART7
PTS636SL50LFS_PART8
PTS636SL50LFS_PART9
PTS636SL50LFS_PART10
