CU-Rocketry/kicad-library/3d_models/ABM8-272-T3_ABR.step

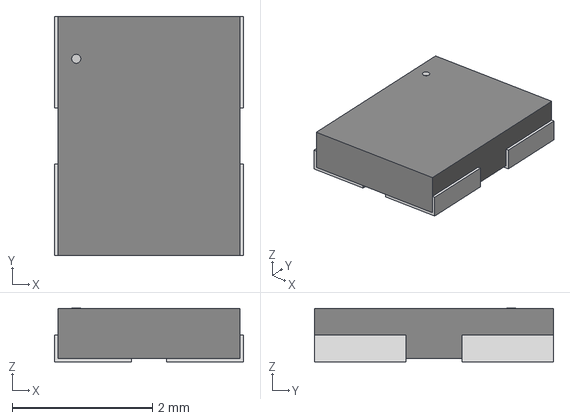
[picture p57: CAD file, 2025-03-01]
3d_models/ABM8-272-T3_ABR.step
2.69 x 3.40 x 0.765 mm
