CU-Rocketry/kicad-library/3d_models/ESP32-C3-MINI-1-H4.STEP

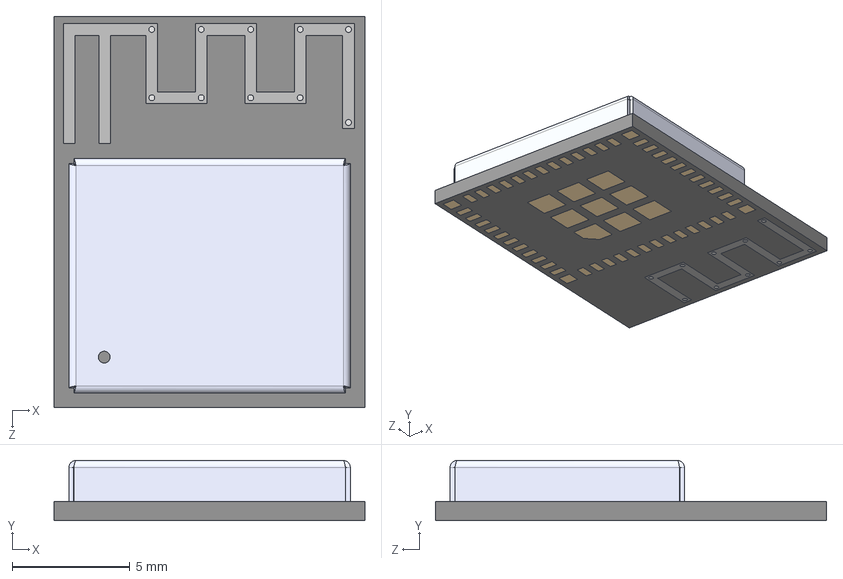
[picture p58: CAD file, 2025-03-01]
3d_models/ESP32-C3-MINI-1-H4.STEP
13.2 x 2.55 x 16.6 mm
