CU-Rocketry/kicad-library/3d_models/TCA8418RTWR.step

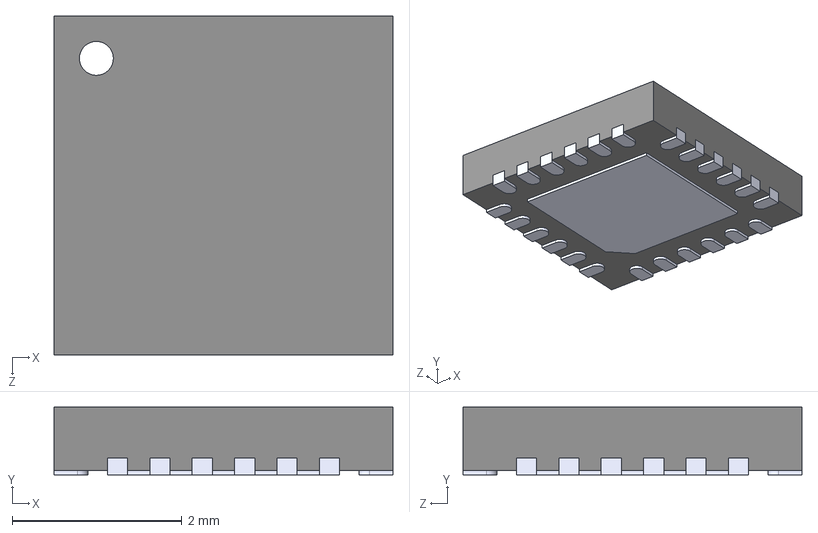
[picture p59: CAD file, 2025-03-01]
3d_models/TCA8418RTWR.step
4.00 x 0.8 x 4.00 mm
