CU-Rocketry/kicad-library/(list of files, cad)

Other CAD files:
3d_models/Connector_Coaxial_RFSOLUTIONS_CON-SMA-EDGE-S.step
3d_models/530480210.step
3d_models/Wurth_ScrewTerminal_691137710002.step
