CU-Rocketry/kicad-library/(commit log)

2025-03-01 Add PTS636SL50LFS 3d model and footprint
    [PTS636SL50LFS.stp]
2025-03-16 Update footprints
2025-03-16 Add WeAct epaper
    [WeAct-EpaperModule-2.13.step]
2025-03-17 Add SHOU HAN footprints
2025-03-31 Add CT09E-04T273-5 buzzer
    [CT09E-04T273-5.stp]
2025-03-31 Add B38G3RGB LED footprint
2025-03-31 Fix ESP32 3d model
2025-04-01 Create MCP96RL00 thermocouple I2C converter symbol
2025-04-07 Add ROHM BUxxSD5 footprint and symbol
2025-04-07 Add ROHM BUxxSD5WG 3D model
    [SSOP5_ROM.step]
2025-04-07 Add 3D models to ROHM SSOP5 footprints
2025-06-30 Add Wio-E5 footprint
2025-06-30 Add Wio-E5 3D model
    [Wio-E5.stp]
2025-06-30 Moved RFIO port to bottom to make space for antenna network
2025-06-30 Annotated Wio-E5 alternate pin functions
2025-07-01 Add Qwiic libraries
    [BM04B-SRSS-TB.STEP, SM04B-SRSS-TB.STEP]
2025-07-01 Add Cortex debug header footprint
    [3220-10-0100-00.STEP]
2025-07-06 Fix wrong pin numbering on BUxxSD5 symbol
2025-07-06 Add abracon GPS ceramic patch antenna
    [APAE1575R1820ABDC1-T.STEP]
2025-07-06 Add MSD-4-A microSD card connector
    [MSD-4-A.STEP]
2025-07-06 Added Teseo-LIV3R
    [TESEO-LIV3R.stp]
2025-07-06 Added Wio-SX1262:
    [Wio-SX1262.step]
2025-07-08 Add BUK9K25-40RAX
    [BUK9K25-40RAX.stp]
2025-07-28 Add AMASS XT60PW-M connector footprint and 3D model
    [XT60PW-M.STEP]
2025-07-28 Create ZXCT180 current sense IC library
2025-07-28 Add Wurth Screw Terminal 691137710002 footprint and 3D model
    3D model not yet attached to footprint
    [Wurth_ScrewTerminal_691137710002.step]
2025-07-29 Add Same Sky UJ20-C-H-G-SMT-P16_TR USB-C connector
    [UJ20-C-H-G-SMT-P16-TR.step]
2025-07-29 Fix Wurth screw terminal margin
2025-07-29 Add default footprint to Qwiic
2025-08-06 Add keystone 2997 battery holder
    [Keystone_BAT_2997.step]
2025-08-06 Add Same Sky SPDT SLW-864574-5A-RA-N-D
    [SLW-864574-5A-RA-N-D.step]
2025-08-23 Add symbols for Dan's ESC
2025-08-24 Add 3D models for XT30 and STM32 3x3 P0.5 QFN-20
    [STM32C011F4U6TR.STEP, XT30PW-F.STEP, XT30PW-M.STEP]
2025-08-27 Add Wurth SMD WCAP-ASLI capacitor footprints and 3D models
2025-10-10 Fix pin numbering to match KiCad symbol
2025-11-07 Move CNC Tech 3220 to Connector_CNC_Tech library
2025-11-07 Create CNC Tech 3220-14
    [3220-14-0100-00.STEP]
2025-11-08 Create ST_Sensor_IMU.kicad_sym
    Includes LSM6DSV80X
2025-11-10 Add symbol and footprints for ST IIS2MDC magnetometer
2025-11-13 Create AMASS XT connector library with 3D models
    Footprints are from KiCad library, 3D models added
2025-11-13 Add symbol, footprint, and 3D model for Same Sky RDS4 rotary DIP switch
    [SW_SameSky_RDS4-8S-1012-73-RA-254-D-67.step]
2025-11-17 Add Same Sky buzzers footprints and 3D models
    CEM-1203(42) and CPT-1207-3TH
    [Buzzer_SameSky_CEM-1203_42.step, Buzzer_SameSky_CPT-1207-3TH.step]
2025-11-18 Cleanup BU33SD5 symbol and footprint
2025-11-22 Add KOA RCUCTE footprint
2025-11-23 Remove solder mask expansion on Same Sky USB-C connector
2025-11-23 Move all Same Sky switches into one footprint library
    [SW_SameSky_SLW-864574-5A-RA-N-D.step]
2025-11-24 Add 3D model for Arlitech 2628 footprint inductor
    [L_Arlitech_AMPI0640ED2R2MT v1.step]
2025-11-24 Add 3D model to B38G3RGB
    [LED_Harvatek_B38G3RGB-10D0003H2U1930.step]
2025-11-26 Add 3D model for KOA Speer RCUTE test point chip
    [TestPoint_KOASpeer_RCUCTE.step]
2025-12-16 RGB LED
    [rgbled.step]
2025-12-16 Sort 19-237/R6GHBHC-M01/2T RGB LED
    [19-237-R6GHBHC-M01-2T.step]
2025-12-17 Add 19-237R6GHBHC-M012T 3D model to footprint
2025-12-17 Add 3D model for IIS2MDC magnetometer
    [ST_IIS2MDCTR.STEP]
2025-12-21 Created Sunltech_SLO0624H footprint
2026-01-19 Add EBYTE E22-400M30S 3D model, footprint, and symbol
    [EBYTE_LoRa_E22-400M30S.step]
2026-01-20 connector sma
    [Connector_Coaxial_RFSOLUTIONS_CON-SMA-EDGE-S.step]
2026-01-20 added same sky vertical switch
    [SW_SameSky_SLW-12689-4A-N-D.step]
2026-01-21 added same sky sky switch and sma rf connector
    [Con_Coaxial_RFSOLUTIONS_CON-SMA-EDGE-S.step, SW_SameSky_SLW-121456-3A-N-D.step]
2026-01-21 tried commiting files again
    [Con_Coaxial_RFSOLUTIONS_CON-SMA-EDGE-S.step, SW_SameSky_SLW-121456-3A-N-D.step]
2026-01-26 usb smd
    UP20-C-F-G-FL-1-P12-TR
    [UP20-C-F-G-FL-1-P12-TR.step]
2026-01-27 added smd usb
    [UJ20-C-H-G-SMT-5-P16-TR.step]
2026-01-27 added smd samtec header
    [Samtec_FTSH-107-01-X-DV-K-TR.step]
2026-01-28 added ntr4003 mosfet
    [NTR4003NT1G.stp]
2026-02-12 added smd buzzer model
    [Buzzer_CMT-7525-03-SMT-TR.step]
2026-02-18 added 1610 tvs diode footprint
    [TVS_ESDA7P120-1U1M.step]
2026-02-26 Add footprints and symbols for CUR ground station power
    [XDFN8_1P6X1P2_onsemi.step]
2026-03-05 Add same sky TB0011-350-02GR 3D model
    [Same_Sky_TB0011-350-02GR.step, TB0011-350-03GR.step]
2026-03-26 Create NCP186 footprint
2026-06-19 Add ublox SAM-M10Q
    [ublox-SAM-M10Q-00B.step]
2026-06-27 Create new samesky USB C connector footprint
    UJ20-C-H-G-SMT-2A-P16-TR
    [UJ20-C-H-G-SMT-2A-P16-TR.step]
2026-06-27 Create new Samtec STDC14 header footprint
    [FTSH-107-01-L-DV-K.step]
2026-06-29 Add MPD BA1AAPC footprint
    [BA1AAPC.step]
2026-06-29 Fix battery holder pad numbering
2026-06-29 Update battery holder silkscreen
2026-07-04 Add GCT USB4940
    [GCT_USB4940-00-A.step]
2026-07-04 Add radial D13.5mm supercapacitor
    [CP_Radial_D13.5mm_P5.00mm_H8.00mm.step]
2026-07-07 Add Wio-S3 and cleanup RF_Module_Seeed libraries
    [Wio-S3 Wireless Module_3D.step]
2026-07-07 Rearrange antenna pins in symbol
2026-07-11 Add Johanson 2450AT42E010B antenna
2026-07-11 Add chip antenna 3D model
    [RF_Antenna_Johanson_2450AT42E010BE.STEP]
2026-07-12 Show chip antenna mounting direction in silkscreen
2026-07-12 Remove solder mask expansion from UJ20 USB C
2026-07-15 Add GND keepout on top layer under chip antenna
2026-09-04 add smt slide switch
    [SLW-865144-2A-N-SMT-TR.step]
2026-09-04 different side switch
    [450404015514.step]
2026-11-09 Update RCUCTE footprint to show value in silk
    This way you can set the label by setting the value
    You just have to have an MPN field
