CU-Rocketry/kicad-library/(notices)

Notices in the files:
3d_models/CP_Radial_D13.5mm_P5.00mm_H8.00mm.step:
Copyright (C) 2026, KiCAD
This work is licensed under the
[Creative Commons CC-BY-SA 4.0 License](https://creativecommons.org/licenses/by-sa/4.0/legalcode),
with the following exception:
project files under this or any other license agreement. However, if you wish to distribute
3d_models/PTS636SL50LFS.stp:
author */ ('License CC BY-ND 4.0'),
